T-labDevelopment/HA750BL-Mount/stl/HA750BL_RevC_lower_frame_print.stl

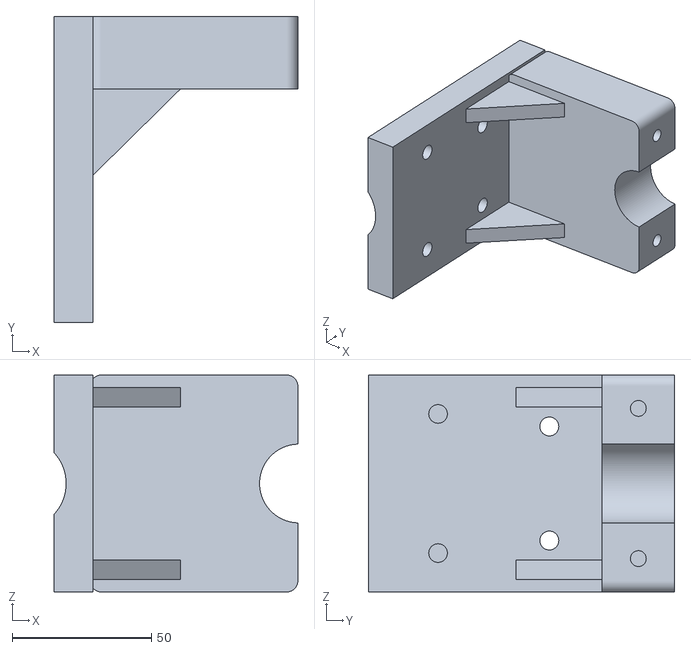
[picture p1: CAD file, 2026-10-23]
stl/HA750BL_RevC_lower_frame_print.stl
87.6 x 110.0 x 78.0
