T-labDevelopment/HA750BL-Mount/stl/HA750BL_RevC_bridge_print.stl

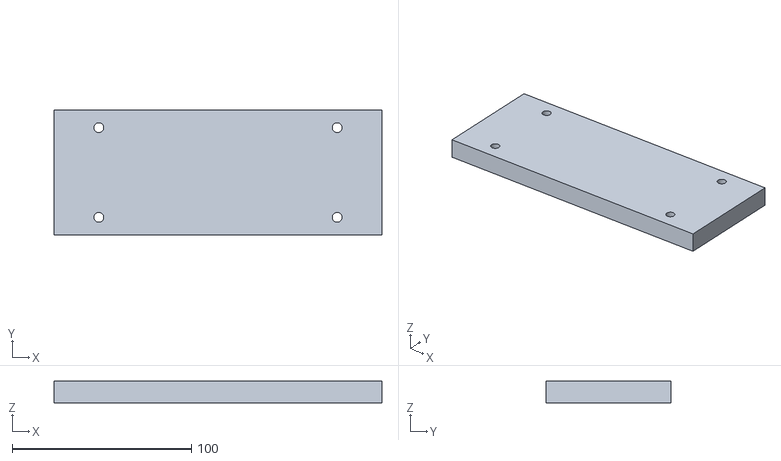
[picture p2: CAD file, 2026-10-23]
stl/HA750BL_RevC_bridge_print.stl
183.0 x 70.0 x 12.0
