T-labDevelopment/HA750BL-Mount/stl/lower_cap_pole32.stl

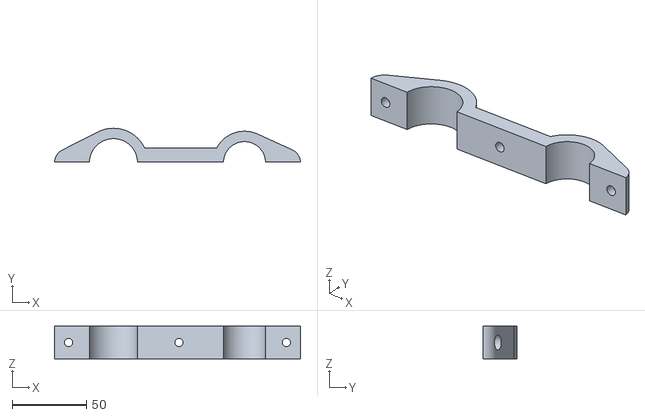
[picture p3: CAD file, 2026-10-23]
stl/lower_cap_pole32.stl
165.2 x 22.5 x 22.0
