T-labDevelopment/HA750BL-Mount/stl/upper_base_pole32.stl

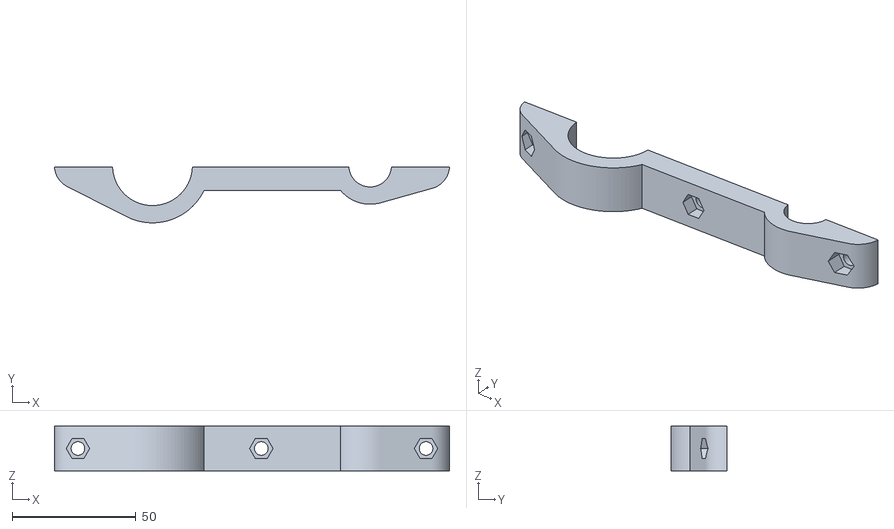
[picture p4: CAD file, 2026-10-23]
stl/upper_base_pole32.stl
159.7 x 22.5 x 18.0
