T-labDevelopment/HA750BL-Mount/stl/HA750BL_RevC_lower_cap_print.stl

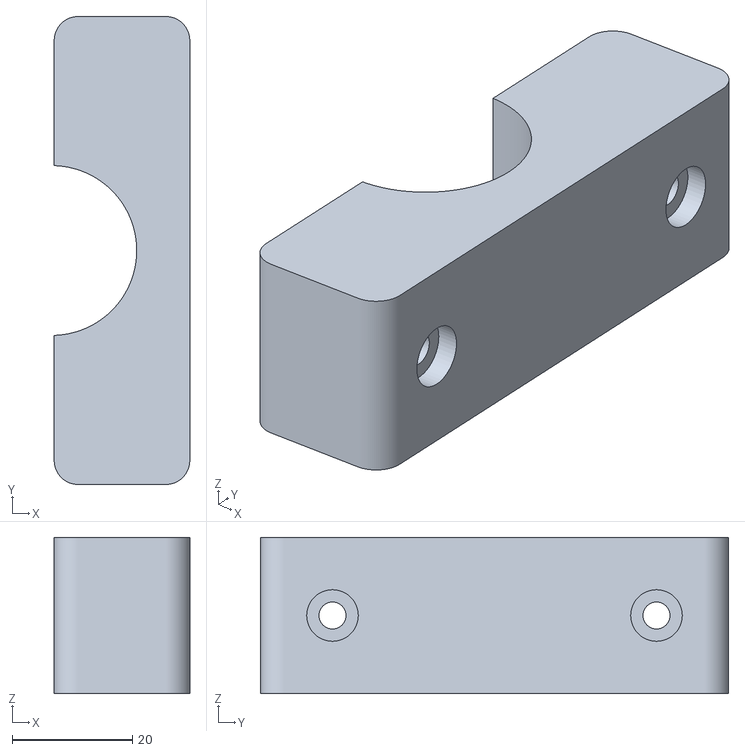
[picture p5: CAD file, 2026-10-23]
stl/HA750BL_RevC_lower_cap_print.stl
22.6 x 78.0 x 26.0
