T-labDevelopment/HA750BL-Mount/stl/HA750BL_RevB_frame.stl

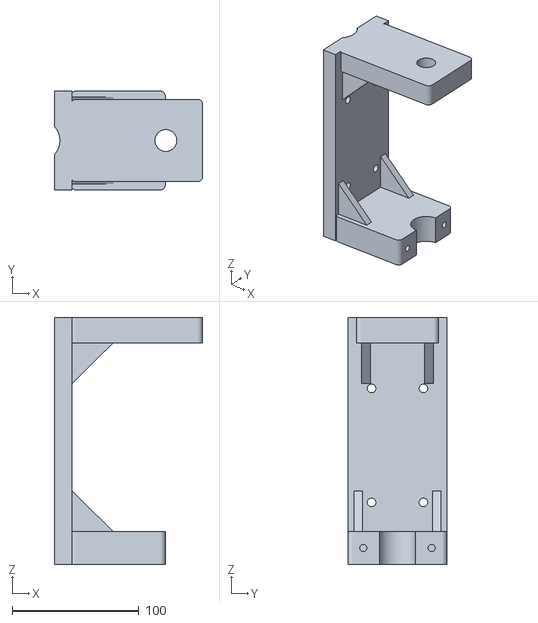
[picture p6: CAD file, 2026-10-23]
stl/HA750BL_RevB_frame.stl
117.0 x 78.0 x 195.0
