T-labDevelopment/HA750BL-Mount/stl/HA750BL_RevC_upper_frame_print.stl

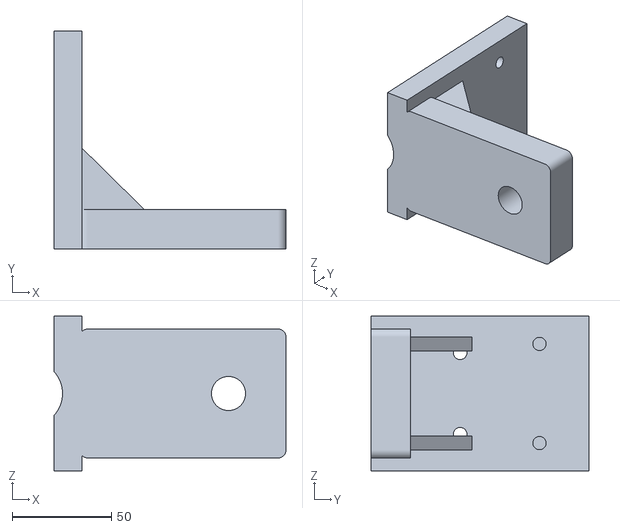
[picture p7: CAD file, 2026-10-23]
stl/HA750BL_RevC_upper_frame_print.stl
117.0 x 110.0 x 78.0
