T-labDevelopment/HA750BL-Mount/(list of files, cad)

Other CAD files:
stl/lower_base_pole32.stl
stl/HA750BL_RevB_lower_cap.stl
stl/HA750BL_RevB_frame_print.stl
stl/upper_cap_pole32.stl
stl/HA750BL_RevB_lower_cap_print.stl
cad/HA750BL_U_frame_RevB.scad
