T-labDevelopment/HA750BL-Mount/images/assembly_pole32.png

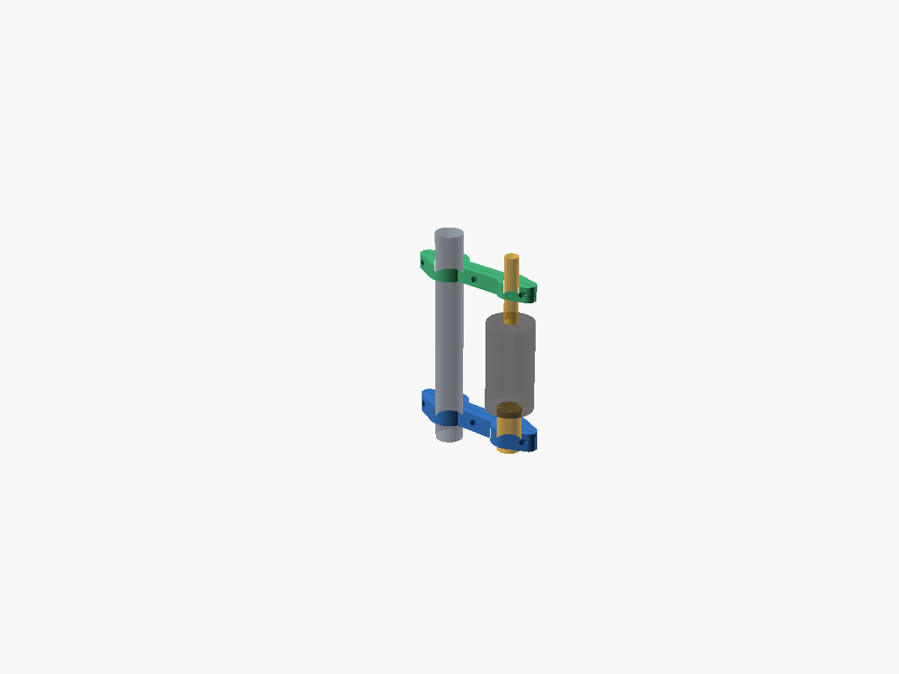
images/assembly_pole32.png
