T-labDevelopment/HA750BL-Mount/images/HA750BL_RevB_assembly.png

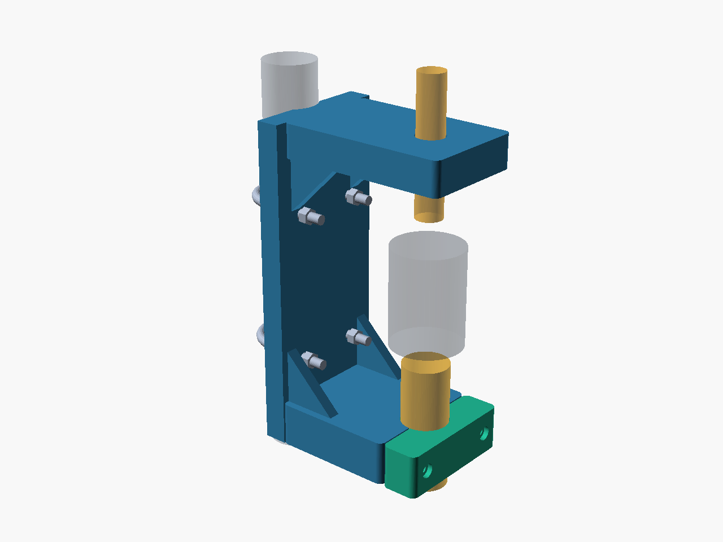
images/HA750BL_RevB_assembly.png
