T-labDevelopment/HA750BL-Mount/images/HA750BL_RevC_assembly.png

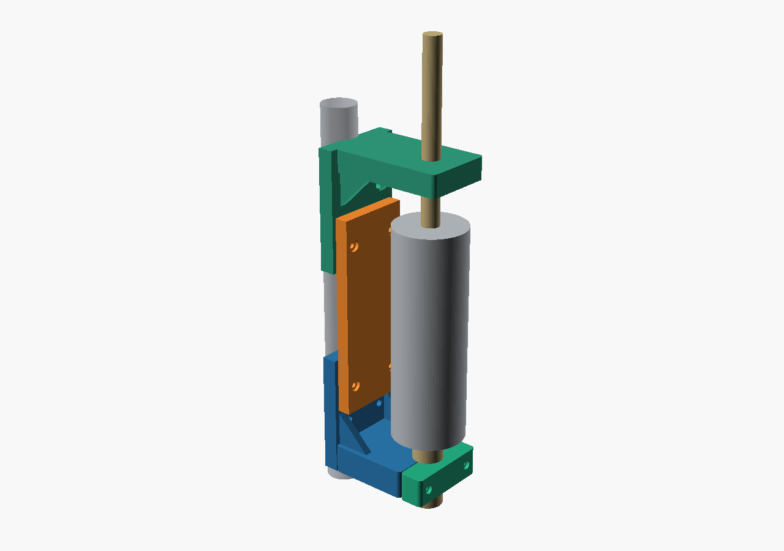
images/HA750BL_RevC_assembly.png
