T-labDevelopment/HA750BL-Mount/VALIDATION.md

# Rev.B CAD検証結果 — 2026-10-21

## 実行結果

- 形状生成：OpenSCADを使い、`frame`・`lower_cap`・`frame_print`・`lower_cap_print`の4つのSTLを出力。
- 括弧・構文：OpenSCADによるCGAL 3D形状生成は正常終了。
- 形状メッシュ：`trimesh`により各STLは単一閉曲面（watertight=True、1 component）。
- Bambu Lab A1造形範囲：`frame_print`の寸法117×195×78mmを検証し、256×256×256mmに収まる。
- Uボルト穴4箇所、M4貫通穴2箇所、M4インサート下穴2箇所、上部貫通穴をパラメトリック作成。

## 実機未検証・製作前に必要な確認

1. ポールの実外径、Uボルトの実物脚ピッチ・脚長・座金ナットとの取り合い。
2. アンテナ上部φ16と下部約φ28の同軸性、**実際の高さ差172mm**（設計仮定）との適合。
3. 下部φ28が非回転の固定円筒であること。コネクター可動部なら固定不可。
4. 給電部フィン最大直径、放熱穴、同軸ケーブル・コネクター脱着の余裕。
5. 上部穴を通すための組立可能性。太い継手や折曲機構を通せるか。
6. 実プリントの寸法、熱圧入インサート製品別下穴径・強度、ねじ長さ、PETG層方向と支持強度。
7. 屋外設置時の風荷重、振動、経時クリープ、耐候性、二次落下防止。
8. 取り付け前後のSWR比較。上部の金属ネジはないが樹脂や周辺金具による変化は未確認。
9. Bambu Studioスライスでのサポート・オーバーハング・プリント時間・フィラメント消費。

**評価範囲の明示**：STLが閉曲面であることは実使用強度・嵌合・屋外安全を保証しない。実装・寸法合わせ・実機試験は未実施。
