T-labDevelopment/HA750BL-Mount/CHANGELOG.md

# CHANGELOG

## Rev.C — 2026-10-23
- 現物写真でRev.Bの172mm保持穴中心間隔が足りないことを確認。放熱フィンが支柱と干渉。
- 上下L型保持部を独立させ、それぞれをM6 Uボルト1本でポールに取り付ける分割式コの字マウントへ再設計。
- 中央の補強プレートのみ距離に応じて再造形できる構造へ変更（初期仮寸法280mm、対応230～340mm）。
- φ16貫通ガイド、約φ28下部M4熱圧入式押さえを維持。Rev.B下部押さえの寸法とSTL形状は互換。
- M5熱圧入式中央補強プレートを追加。実機再装着・強度は未検証。

## Rev.B — 2026-10-21
- ユーザー指定のコの字一体構造に変更。
- ポール側をM6 Uボルト2本（合計4穴）に変更。φ32 mmポールは仮値、M6/25A足長+10 UボルトのP=41 mmを例示。
- 上部φ16 mmは金属クランプを廃止して樹脂製φ17.2 mm貫通ガイドに変更。
- 下部約φ28 mmは分割クランプを採用し、M4ボルト2本とM4熱圧入インサート2個で固定。
- OpenSCAD正本・印刷用STL・組立画像・CADメッシュ検査・生成スクリプトを更新。
- Rev.Aデータは削除せず比較・履歴確認用に維持。

## Rev.A — 2026-10-21
- φ16/φ28ポールブリッジクランプ4部品の初期試作。
