T-labDevelopment/HA750BL-Mount/(commit log)

2026-10-22 docs: initialize HA750BL-Mount design repository
2026-10-22 cad: add Rev.B U-frame master parametric source
    [HA750BL_U_frame_RevB.scad]
2026-10-22 cad: preserve Rev.A split-clamp source for reference
    [HA750BL_dual_clamp.scad]
2026-10-22 ci: generate STL and assembly previews from OpenSCAD on source changes
2026-10-22 build: refresh generated STL and assembly images
    [HA750BL_RevB_frame.stl, HA750BL_RevB_frame_print.stl, HA750BL_RevB_lower_cap.stl, HA750BL_RevB_lower_cap_print.stl, lower_base_pole32.stl, lower_cap_pole32.stl, upper_base_pole32.stl, upper_cap_pole32.stl]
2026-10-22 ci: also render Rev.A reference assembly preview
2026-10-22 docs: link generated print STLs and GitHub build workflow
2026-10-23 cad: add modular Rev.C after real-antenna fit failure
    [HA750BL_U_frame_RevC.scad]
2026-10-23 docs: make modular Rev.C current after failed Rev.B fit
2026-10-23 ci: build and validate Rev.C modular U-mount printable STLs
